sasodoma/phase-checker/zero_crossing_detector/zero_crossing_detector.png

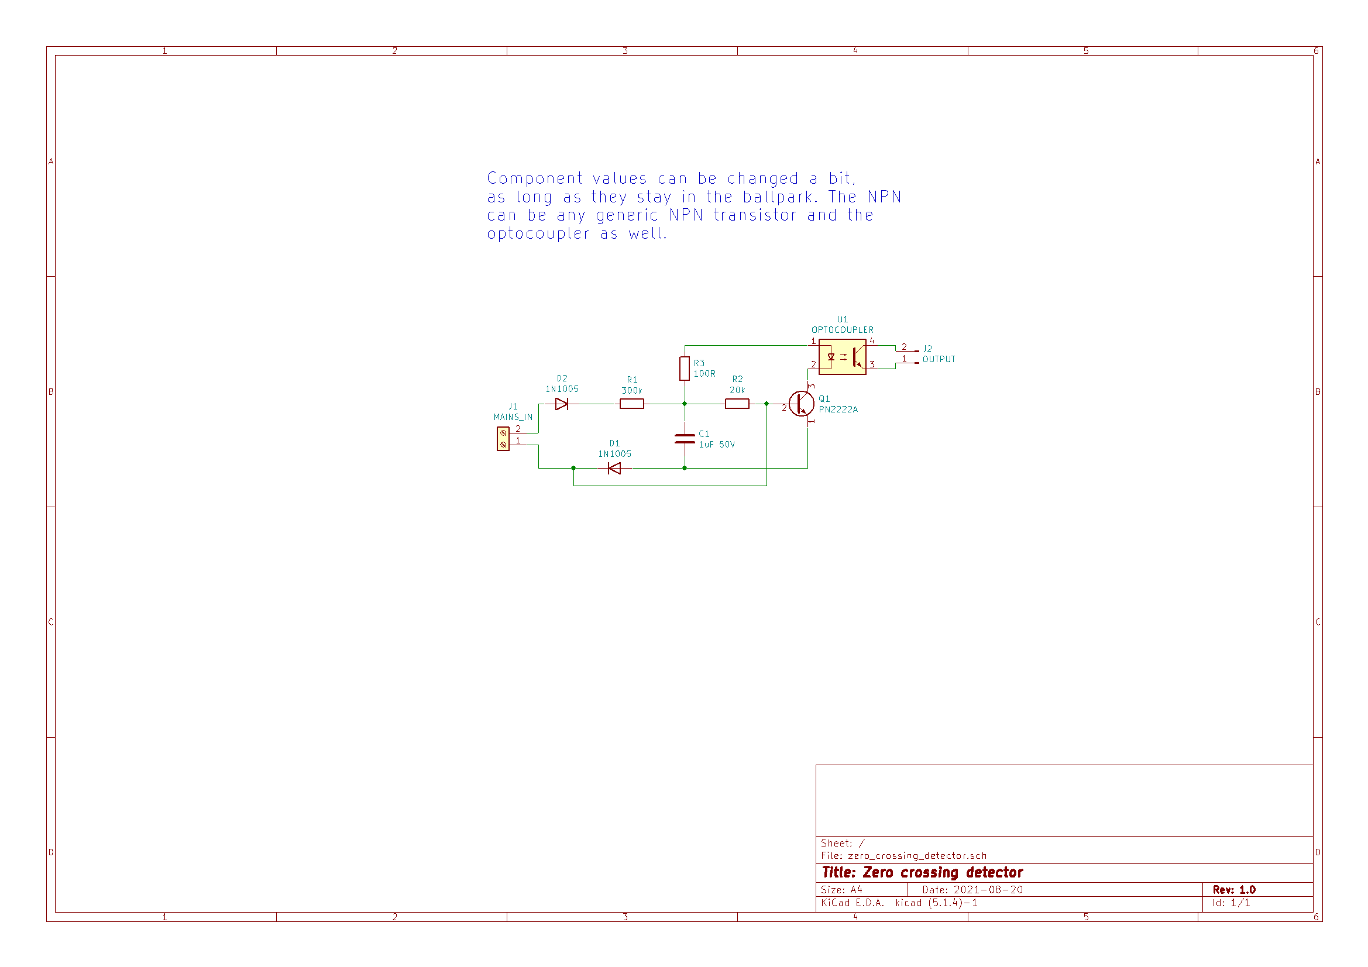
zero_crossing_detector/zero_crossing_detector.png
