sasodoma/phase-checker/zero_crossing_detector/zero_crossing_detector.sch

## KiCad design zero_crossing_detector/zero_crossing_detector.sch (2021-08-20)

Schematic: zero_crossing_detector.sch

Parts:
C1: 1uF 50V
D1, D2: 1N1005
J1: MAINS_IN
J2: OUTPUT
Q1: PN2222A; TO-92_Inline
R1: 300k
R2: 20k
R3: 100R
U1: OPTOCOUPLER; DIP-4_W7.62mm

Notes on the sheet:
Component values can be changed a bit, as long as they stay in the ballpark. The NPN can be any generic NPN transistor and the optocoupler as well.
