sasodoma/phase-checker/(commit log)

2021-08-19 Basic phase checker, drifts very fast
    [phase_checker.ino]
2021-08-19 Implemented period synchronisation
    Works kinda OK while the mains is connected,
    but when disconnecting (perhaps to move to
    another outlet) it quickly looses sync.
    [phase_checker.ino]
2021-08-20 Implemented a lower level method with timers.
    The old implementation was renamed to phase_checker_simple,
    the new method uses Timer1 to generate a 50 Hz reference
    signal and the Input Capture function of the timer.
    The clock divider is set to 8 so the interval is 500 ns.
    One mains cycle is therefore approximately 40 000 timer
    counts. While plugged in the frequency is constantly synced
    to the input. I still need to find a way to keep a precise
    clock when unplugged. The drift is now slow enough to compare
    two outlets that are close to eachother, but ideally I want
    to have the ability to walk to another building and find the
    matching phase there so the clock needs to keep approximate
    sync for m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
    [phase_checker.ino, phase_checker_simple.ino]
2021-08-20 Implemented period averaging.
    The period of the last 256 cycles is now stored
    and upon disconnecting the mains, it is averaged
    to produce a better approximation of the original
    frequency. This works quite well when tested with
    another MCU as a frequency source, the drift is
    very low even over 10 minutes. However it turns out
    that the grid frequency is anything but stable.
    Variations of 10 mHz are perfectly acceptable for
    the grid but it means going completely out of phase
    in about 50 seconds.
    [phase_checker.ino]
2021-08-20 Added zero crossing detection circuit schematic
    [zero_crossing_detector.sch]
2021-08-20 Add missing wire
    [zero_crossing_detector.sch]
2022-08-14 Current state
